ArkX-Lab/Sitara-Project/HW/Document/N1_Block Diagram/Sitara Project_Block Diagram.pptx

Power Input 1
(DC Barrel Jack)

Power Input 2
(USB Type-C)

PMIC Power-On
(Push-Button 1)

PMIC
(TPS65217DRSLR)

3.3V LDO1
(MIC5209YM-TR)

Sitara Processor
(AM3358BZCZ100)

Mezzanine Connector B
(10144517-101802LF)

Main Oscillator
(24MHz)

VTT Regulator
(BD3539FVM-TR)

EEPROM
(AT24C16)

Sub Oscillator
(32.768kHz)

USB1
(USB2.0 Mini-B)

DDR3L Memory
(MT41K256M)

Micro-SD Card Connector (TF-01A)

USB – UART
(CP2102)

RJ45
(HR911105A)

Test LEDs

Test Push-Buttons

eMMC
(MTFC32GAZAQHD-WT)

Mezzanine Connector A
(10144517-101802LF)

## Slide 2

Power Input 1
(DC Barrel Jack)

EXT_VIN_DC

PMIC
(TPS65217DRSLR)

PGOOD_LDO1/2

VOUT_SYS

3.3V LDO1
(MIC5209YM-TR)

MCU
(STM32C011F6U6TR)

VDD/VDDA

Power Input 2
(USB-C Conn.)

EXT_VIN_USB

3.3V LDO2
(AM1117-3.3)

SCL

PB6

PMIC Power-On
(Push-Button 1)

PB_IN

SDA

PB7

PMIC Reset
(Push-Button 2)

nRESET

PGOOD

PA2

PA1

PMIC Power En.
(Slide Switch 1)

PWR_EN

nWAKEUP

nINT

PA4

PA3

PMIC Output Rails
(Connector)

1. DC Barrel Jack
2. PMIC(TPS65217)
3. Power Button
4. LDO(MIC5209)
5. Sitara Processor
6. Oscillator (24MHz/32.768kHz)
7. USB2.0 Mini-B Connector
8. DDR3L Memory

PMIC Status Signals
(Connector)

1. VTT Regulator(BD3539FVM-TR)
2. EEPROM(AT24C16)
3. Micro SD Card Connector(TF-01A)
4. Ethernet PHY(LAN8710)
5. RJ45 Connector(HR911105A)
6. USB-UART Bridge(CP2102)
7. USB2.0 C-Type Connector
8. eMMC(MTFC32GAZA)

PA0

1. Mezzanine Connector (10144517-101802LF)
2. Mount Holes
3. Test LEDs
4. Test Push-Buttons

## Slide 3

Power Input 1
(DC Barrel Jack)

EXT_VIN_DC

PMIC
(TPS65217DRSLR)

PGOOD_LDO1/2

VOUT_SYS

3.3V LDO1
(MIC5209YM-TR)

MCU
(STM32C011F6U6TR)

VDD/VDDA

Power Input 2
(USB-C Conn.)

EXT_VIN_USB

3.3V LDO2
(AM1117-3.3)

SCL

PB6

PMIC Power-On
(Push-Button 1)

PB_IN

SDA

PB7

PMIC Reset
(Push-Button 2)

nRESET

PGOOD

PA2

PA1

PMIC Power En.
(Slide Switch 1)

PWR_EN

nWAKEUP

nINT

PA4

PA3

PMIC Output Rails
(Connector)

1. DP5VS
2. DP1.35V (DCDC1’s Vout)
3. DP1.1V (DCDC2’s Vout)
4. DP1.1V (DCDC3’s Vout)
5. DP1.8V (LDO1’s Vout)
6. DP3.3V (LDO2’s Vout)
7. DP1.8V (LDO3’s Vout)
8. DP3.3V (LDO4’s Vout)

PMIC Status Signals
(Connector)

1. MCU PMIC Power Enable
2. MCU PMIC PGOOD
3. MCU PMIC LDO PGOOD
4. MCU PMIC nINT
5. MCU PMIC nWAKEUP
6. MCU I2C1 SCL
7. MCU I2C1 SDA

PA0

## Slide 4

Power Input 1
(DC Barrel Jack)

EXT_VIN_DC

PMIC
(TPS65217DRSLR)

PGOOD_LDO1/2

VOUT_SYS

3.3V LDO1
(MIC5209YM-TR)

MCU
(STM32C011F6U6TR)

VDD/VDDA

Power Input 2
(USB-C Conn.)

EXT_VIN_USB

3.3V LDO2
(AM1117-3.3)

SCL

PB6

PMIC Power-On
(Push-Button 1)

PB_IN

SDA

PB7

PMIC Reset
(Push-Button 2)

nRESET

PGOOD

PA2

PA1

PMIC Power En.
(Slide Switch 1)

PWR_EN

nWAKEUP

nINT

PA4

PA3

PMIC Output Rails
(Connector)

1. DP5VS
2. DP1.35V (DCDC1’s Vout)
3. DP1.1V (DCDC2’s Vout)
4. DP1.1V (DCDC3’s Vout)
5. DP1.8V (LDO1’s Vout)
6. DP3.3V (LDO2’s Vout)
7. DP1.8V (LDO3’s Vout)
8. DP3.3V (LDO4’s Vout)

PMIC Status Signals
(Connector)

1. MCU PMIC Power Enable
2. MCU PMIC PGOOD
3. MCU PMIC LDO PGOOD
4. MCU PMIC nINT
5. MCU PMIC nWAKEUP
6. MCU I2C1 SCL
7. MCU I2C1 SDA

PA0

## Slide 5

XC7Z010 Test B’d (Rev.A)

External Connector
(Edge Connector : DDR4 SODIMM Form Factor)

JTAG
Digilent JTAG-HS3 Compatible

AMD Xilinx
Zynq
System-On-Chip
(XC7Z010-1CLG400)

QSPI FLASH
(16MB)

PS Clock OSC
(33.33MHz)

PL Clock OSC
(50MHz)

VTT Regulator
(0.675V)

DDR3L Memory
(512MB)

DDR3L Memory
(512MB)

Termination

Rev. A

## Slide 6

# 1Q TSN MPW - Block Diagram

Clock domain :
2.5 or 25MHZ
(from PHY IC)

Clock domain :
100MHz
(from Oscillator)

1Q TSN MPW

Raspberry
PI4

SPI
Periph
(Master)

GPIOs
(Interrupt
Avaliable)

10/100
MAC IP

Rx MAC FIFO
(4KB)

TSN Rx module

1Q
TSN
I/F

Frame Rx
FIFO

Frame Tx
FIFO

SPI
Slave
I/F

SPI
Slave
IP

Side-band Signals
(Rx INT, Status, Etc)

SCLK

MOSI

Tx MAC FIFO
(4KB)

TSN Tx module

Reg. Write
FIFO

Reg. Read
FIFO

MISO

System Reg
module

NSS

TSN Control
module

## Slide 7

재설계 1Q TSN(V3) Block Diagram (Datapath)

Host Processor

PCIe Gen.2

Clock domain :
from Oscillator

Clock domain :
from XDMA

Tri-Mode Ethernet MAC

osc_diff_clk

8-bit AXIS

TSN Rx module

8-bit AXIS

AXI4-Stream Data Width Converter
(8bit to 128bit)

128-bit AXIS

AXI-Stream Data FIFO
(128bit)

CDC module

CDC FIFO 1
(TSN Control & Config)

CDC FIFO 2
(System Counter)

CDC FIFO 3~6
(Tx Timestamp 1~4)

CDC FIFO 7
(Tx Status)

CDC FIFO 8
(Rx Status)

CDC FIFO 9
(Other Status)

AXI-Stream Data FIFO
(128bit)

128-bit AXIS

XDMA
(PCIe Gen.2)

CDC FIFO

AXI4L Reg
module

128-bit AXIS

CDC FIFO

System Reg
module

Dedicated Wire

Dedicated Wire

32-bit AXIL

8-bit AXIS

TSN Tx module

CDC FIFO

TSN Clock

System Counter

Timestamp Generator

Dedicated Wire

Reset & Clock
Controller
