ArkX-Lab/Sitara-Project/HW/Document/BOM/01_Required Part List/Main Part List of BeagleBoneBlack.xlsx

Main Part List of BeagleBoneBlack
No. | Category |  | Part Name | Description | Manufacturer | Req. Qty | Supplier 1 : JLCPCB (LCSC) |  |  | Supplier 2 : Digikey |  |  | Purchase Price | Datasheet | Note
 | Main | Sub Category |  |  |  |  | Stock | Unit Price | Total Price | Stock | Unit Price | Total Price
1 | IC | PMIC | TPS65217CRSLR | Single-Chip PMIC for Battery-Powered Systems | Texas Instruments | 1 | 305 | $2.231 | $2.23 | 2259 | $5.200 | $5.20 | $2.23 | Datasheet (https://www.ti.com/lit/ds/symlink/tps65217.pdf?HQS=dis-dk-null-digikeymode-dsf-pf-null-wwe&ts=1737040409403)
2 | IC | LDO | TL5209DR | 500-mA Low-Noise Low-Dropout Voltage Regulator With Shutdown | Texas Instruments | 1 | 65 | $1.125 | $1.12 | 0 | $1.520 | $1.52 | $1.12 | Datasheet (https://www.ti.com/general/docs/suppproductinfo.tsp?distId=10)
3 | IC | Buffer | SN74LVC1G07DCKR | Single Buffer/Driver With Open-Drain Output | Texas Instruments | 1 | 11337 | $0.048 | $0.05 | 110269 | $0.100 | $0.10 | $0.05 | Datasheet (https://www.ti.com/lit/ds/symlink/sn74lvc1g07.pdf?ts=1695839538574)
4 | IC | D-FlipFlop | SN74LVC1G74DCTR | Single Positive-Edge-Triggered D-Type Flip-Flop with Clear and Preset | Texas Instruments | 1 | 186 | $0.354 | $0.35 | 23303 | $0.500 | $0.50 | $0.35 | Datasheet (https://www.ti.com/general/docs/suppproductinfo.tsp?distId=10)
5 | IC | Inverter | SN74LVC1G06DCKR | Single Inverter Buffer/Driver With Open-Drain Output | Texas Instruments | 1 | 1456 | $0.065 | $0.07 | 41948 | $0.100 | $0.10 | $0.07 | Datasheet (https://www.ti.com/lit/ds/symlink/sn74lvc1g06.pdf?HQS=dis-dk-null-digikeymode-dsf-pf-null-wwe&ts=1737041288845)
6 | Osc | Osc | 24.576MHz Oscillator | 24.576MHz Oscillator | - | 1 | - | - | - | - | - | - |  |  | 제품 선정 필요
7 | IC | MPU | AM3358BZCZ100 | Up to 1GHz Sitrara ARM Cortex-A8 32-bit RISC Processor | Texas Instruments | 1 | 219 | $12.219 | $12.22 | 149 | $18.790 | $18.79 | $12.22 | Datasheet (https://www.ti.com/lit/ds/symlink/am3352.pdf?HQS=dis-dk-null-digikeymode-dsf-pf-null-wwe&ts=1737014458424)
8 | IC | Buffer | SN74LVC2G241DCUR | Dual Buffer and Driver With 3-State Outputs | Texas Instruments | 1 | 3266 | $0.341 | $0.34 | 14155 | $0.450 | $0.45 | $0.34 | Datasheet (https://www.ti.com/lit/ds/symlink/sn74lvc2g241.pdf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)
9 | IC | Load Switch | TPS2051BDGNR | Current-Limited, Power-Distribution Switches | Texas Instruments | 1 | 0 | $0.960 | $0.96 | 6079 | $0.960 | $0.96 | $0.96 | Datasheet (https://www.ti.com/general/docs/suppproductinfo.tsp?distId=10)
10 | Passive | TVS Diode | TPD4S012DRYR | 4-Channel ESD Solution for USB-HS/USB OTG/USB Charger Interface | Texas Instruments | 2 | 224 | $0.170 | $0.34 | 27863 | $0.690 | $1.38 | $0.34 | Datasheet (https://www.lcsc.com/datasheet/lcsc_datasheet_1809050016_Texas-Instruments-TPD4S012DRYR_C96506.pdf)
11 | IC | DDR3L | D2516ECMDXGJD-U | 4G bits DDR3L SDRAM | Kingston | 1 | - | - | - | 259 | $3.980 | $3.98 |  | Datasheet (https://mm.digikey.com/Volume0/opasdata/d220001/medias/docus/6165/D2516ECMDXG.pdf) | "MT41K256M16TW-107 IT:P"으로 대체 예정
12 | IC | DDR3L | MT41K256M16TW-107 IT:P | 1.35V DDR3L SDRAM | Micron | 1 | 2576 | $1.476 | $1.48 | 1211 | $6.400 | $6.40 | $1.48 | Datasheet (https://wmsc.lcsc.com/wmsc/upload/file/pdf/v2/lcsc/2304140030_Micron-Tech-MT41K256M16TW-107-IT-P_C367428.pdf) | "D2516ECMDXGJD-U"의 대체품
13 | IC | eMMC | MTFC4GLDEA-0M WT TR | MultiMediaCard (MMC) controller and NAND Flash. 153- or 169-ball WFBGA/VFBGA/LFBGA (RoHS 6/6-compliant) | Micron | 1 | EOL | - | - | EOL | - | - |  | Datasheet (https://mm.digikey.com/Volume0/opasdata/d220001/medias/docus/1197/EMMC_Series.pdf) | 단종 => 대체품 검토 필요
14 | IC | eMMC | MTFC32GAZAQHD-WT | FLASH - NAND Memory IC 256Gbit MMC 200 MHz 153-VFBGA (11.5x13) | Micron | 1 | 0 | $20.175 | $20.18 | 794 | $18.710 | $18.71 | $18.71 | Local | "MTFC4GLDEA-0M WT TR"의 대체품
15 | IC | Ethernet Trcv | LAN8710A-EZC-TR | Small Footprint MII/RMII 10/100 Ethernet Transceiver with HP Auto-MDIX and flexPWR® Technology | Microchip | 1 | 17582 | $0.645 | $0.65 | 5178 | $1.580 | $1.58 | $0.65 | Datasheet (https://ww1.microchip.com/downloads/en/DeviceDoc/00002164B.pdf)
16 | IC | AND-Gate | SN74AHC1G09DCKR | Single 2–Input Positive-AND Gate With Open-Drain Output | Texas Instruments | 1 | 1 | $0.054 | $0.05 | 4613 | $0.120 | $0.12 | $0.12 | Datasheet (https://www.ti.com/lit/ds/symlink/sn74ahc1g09.pdf?HQS=dis-dk-null-digikeymode-dsf-pf-null-wwe&ts=1737065378387)
17 | IC | HDMI | TDA19988BHN/C1,557 | Video Transmitter IC I2S HDMI 1.4a, ITU656 64-HVQFN (9x9) Package | NXP | 1 | EOL | - | - | EOL | - | - |  | Datasheet (https://mm.digikey.com/Volume0/opasdata/d220001/medias/docus/957/TDA19988_DS_21_july_2011.pdf) | 단종 => 대체품 검토 필요
 |  |  |  |  |  |  |  |  |  | Total Price (Dollar / Won) |  |  | $38.63
 |  |  |  |  |  |  |  |  |  |  |  |  | $56343.57739
