ArkX-Lab/Sitara-Project/HW/Document/Design/Design Check List/B'd Design Check List.xlsx

Schematic Design Check List
No. | Main Category | Sub Category | Description | Note | Source
1 | DDR Memory | Pin Attribute | "DDR_VREF" Pin => 이 핀은 DDR 입력 버퍼의 스위칭 스레스홀드를 (VDDS_DDR/2)로 설정하는데 사용되는 아날로그 전압이라고 한다. | 이 내용에서 알 수 있는 사실은 DDR 메모리의 타켓 임피던스가 50옴이라는 것이다. 그리고 설계자가 이를 위해, 49.9옴 저항을 연결해주어야 한다는 것이다. | AM335x Sitara Processor Datasheet 21p
2 | DDR Memory | Pin Attribute | "DDR_VTP" Pin => 이 핀은 외부 49.9Ohm 1% 저항과 연결한다고 한다. DDR Input/Output Buffer를 Calibration 하기 위함. | 이 내용에서 알 수 있는 사실은 DDR 메모리의 타켓 임피던스가 50옴이라는 것이다. 그리고 설계자가 이를 위해, 49.9옴 저항을 연결해주어야 한다는 것이다. | AM335x Sitara Processor Datasheet 21p
 | BOOT |  | "LCD_DATA[15:0]" => 이 16개 핀들은 SYSBOOT[15:0] 핀이기도 하다. "PWRONRSTn" 신호의 라이징 엣지에서 래치된다. |  | AM335x Sitara Processor Datasheet 21p
 | Supply Voltage |  | Datasheet "Table 5-3"에 동작 스피드별로 VDD_MPU 전압이 다르다. BBB에서는 1.1V로 공급하는데, AM3358BZCZ100은 1GHz 사양으로서 1.26V가 공급되어야 올바른 것이 아닌가? 그냥 OPP100을 기준으로 생각하면 되나? => PMIC의 DCDC2 전압 설정값을 확인해볼 필요가 있다. Table 5-3 (2)에 OPP100은 500MHz 또는 그 이상의 디바이스에 대해서 적용된다고 한다. 따라서, 1GHz 속도의 AM3358~ZCZ100은 OPP100을 기준으로 하면 되는건가? OPP는 공급 전압에 따라서, 내부적으로 결정되는건가? OPP 설정에 따라 동작 속도를 가변하나? | Table 5-3에는 이전 실리콘 버전의 ARM 동작속도로 기재되어 있다. => Table 3-1의 (1) 참조
 | Decoupling Cap | Core | Core Voltage Decoupling Capacitors의 값 => "Table 5-13"에 따르면, VDD_CORE, VDD_MPU는 각각 최소 10uF 1개와 10nF 8개를 권고한다.
 | Decoupling Cap | I/O & Analog | I/O 및 Analog 핀에 대한 Cap 값들은 "Table 5-14"를 참고한다.
 | Decoupling Cap | Output Capacitor | "Table 5-15" 참조
 | Supply Voltage | USB | USB를 사용하지 않는 경우, 해당 전원 핀의 처리는 "Figure 6-2"의 C를 따른다.
 | Power Monitor |  | VDD_MPU_MON : 사용하지 않는 경우, "Figure 6-7"에 따라 처리할 것
 | Clock | Crystal | OSC0는 RTC를 제외한 모든 영역에서 사용되는 클락의 소스이고, OSC1은 RTC의 클락 소스이다. 외부 크리스탈 주파수 사양과 커패시터 사용은 "Table 6-2"를 참조한다.
 | Reset |  | Power On Reset에 대한 내용은 TRM의 1238p를 참조한다.
 |  |  | NRESET_INOUT 관련 버퍼 회로의 설계 내용은 TRM의 Figure 8-24를 참조한다.
