ArkX-Lab/Sitara-Project/HW/Rev_A/Sitara_Project_Rev_A/Sitara_Project_Rev_A/Sitara_Project_Rev_A.pdf

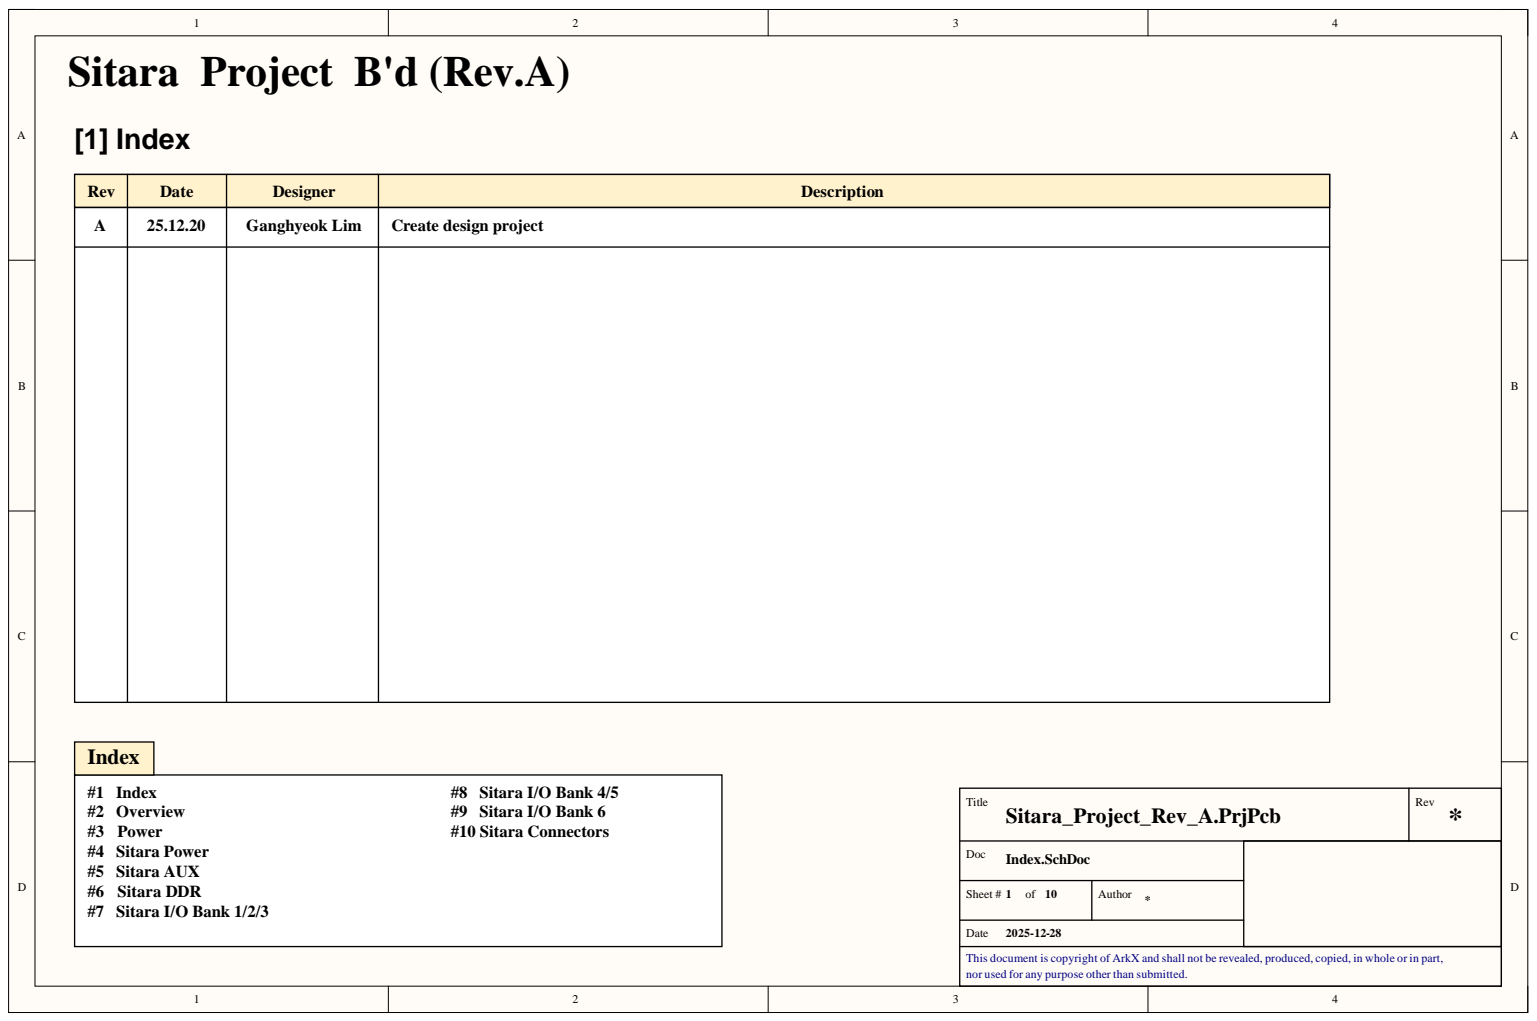
[picture p1: page 1]

Rev | Date | Designer | Description

A | 25.12.20 | Ganghyeok Lim | Create design project

Title Sitara_Project_Rev_A.PrjPcb | Rev *

Doc Index.SchDoc

Sheet # 1 of 10 | Author *

This document is copyright of ArkX and shall not be revealed, produced, copied, in whole or in part,
nor used for any purpose other than submitted.

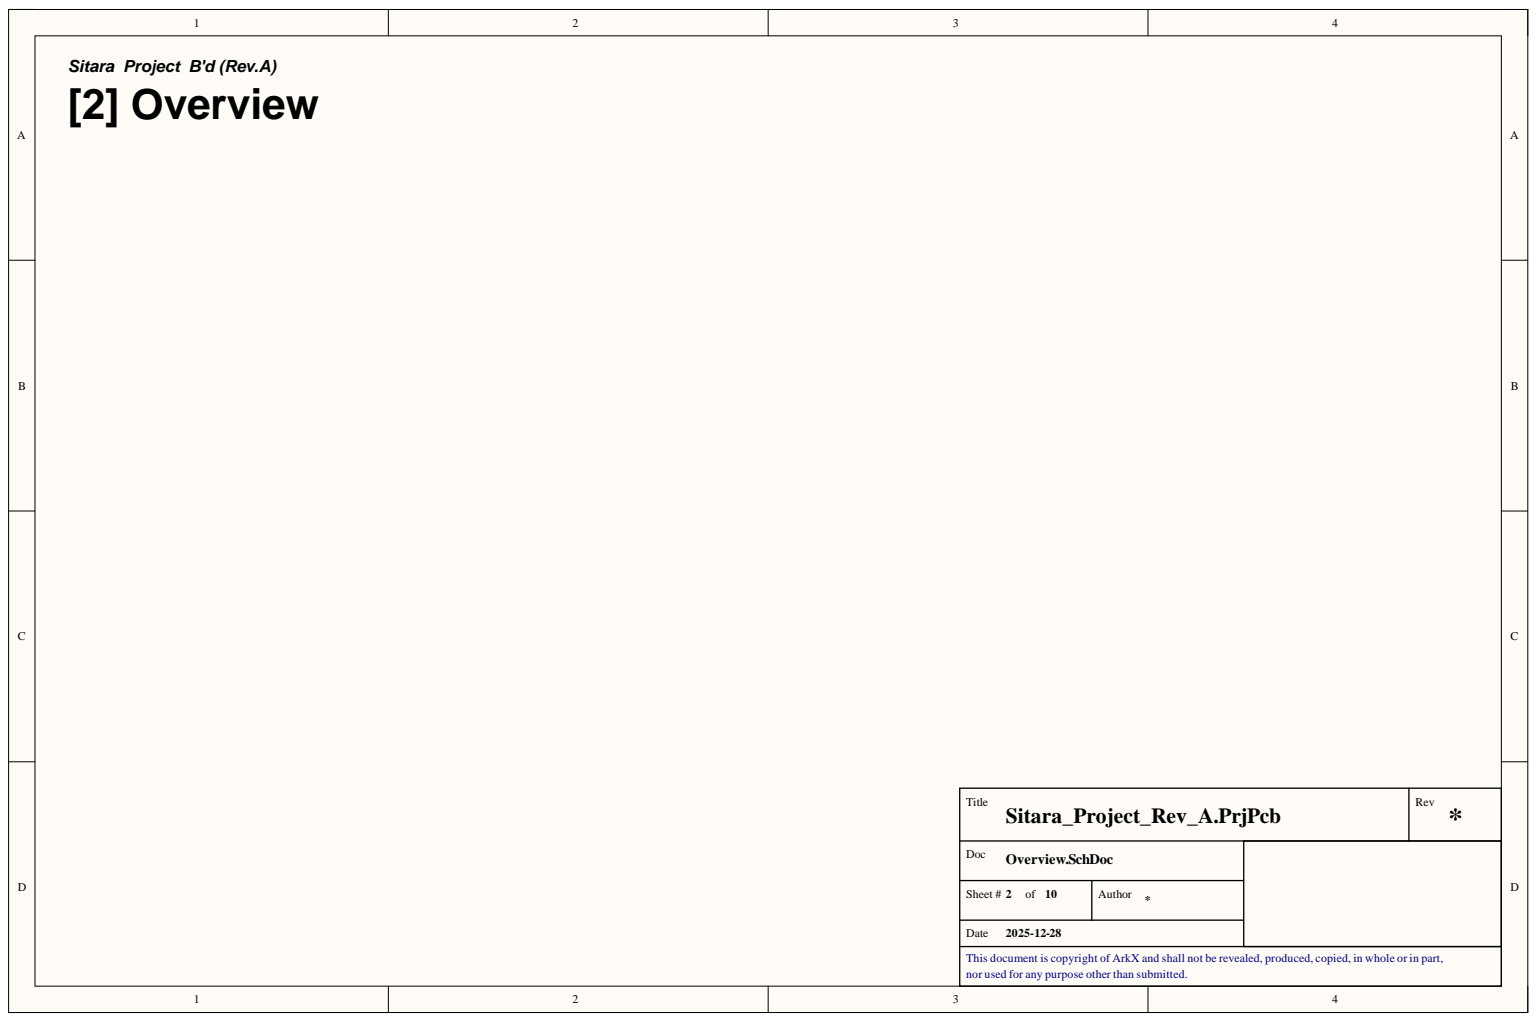
[picture p2: page 2]

Title Sitara_Project_Rev_A.PrjPcb | Rev *

Doc Overview.SchDoc

Sheet # 2 of 10 | Author *

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

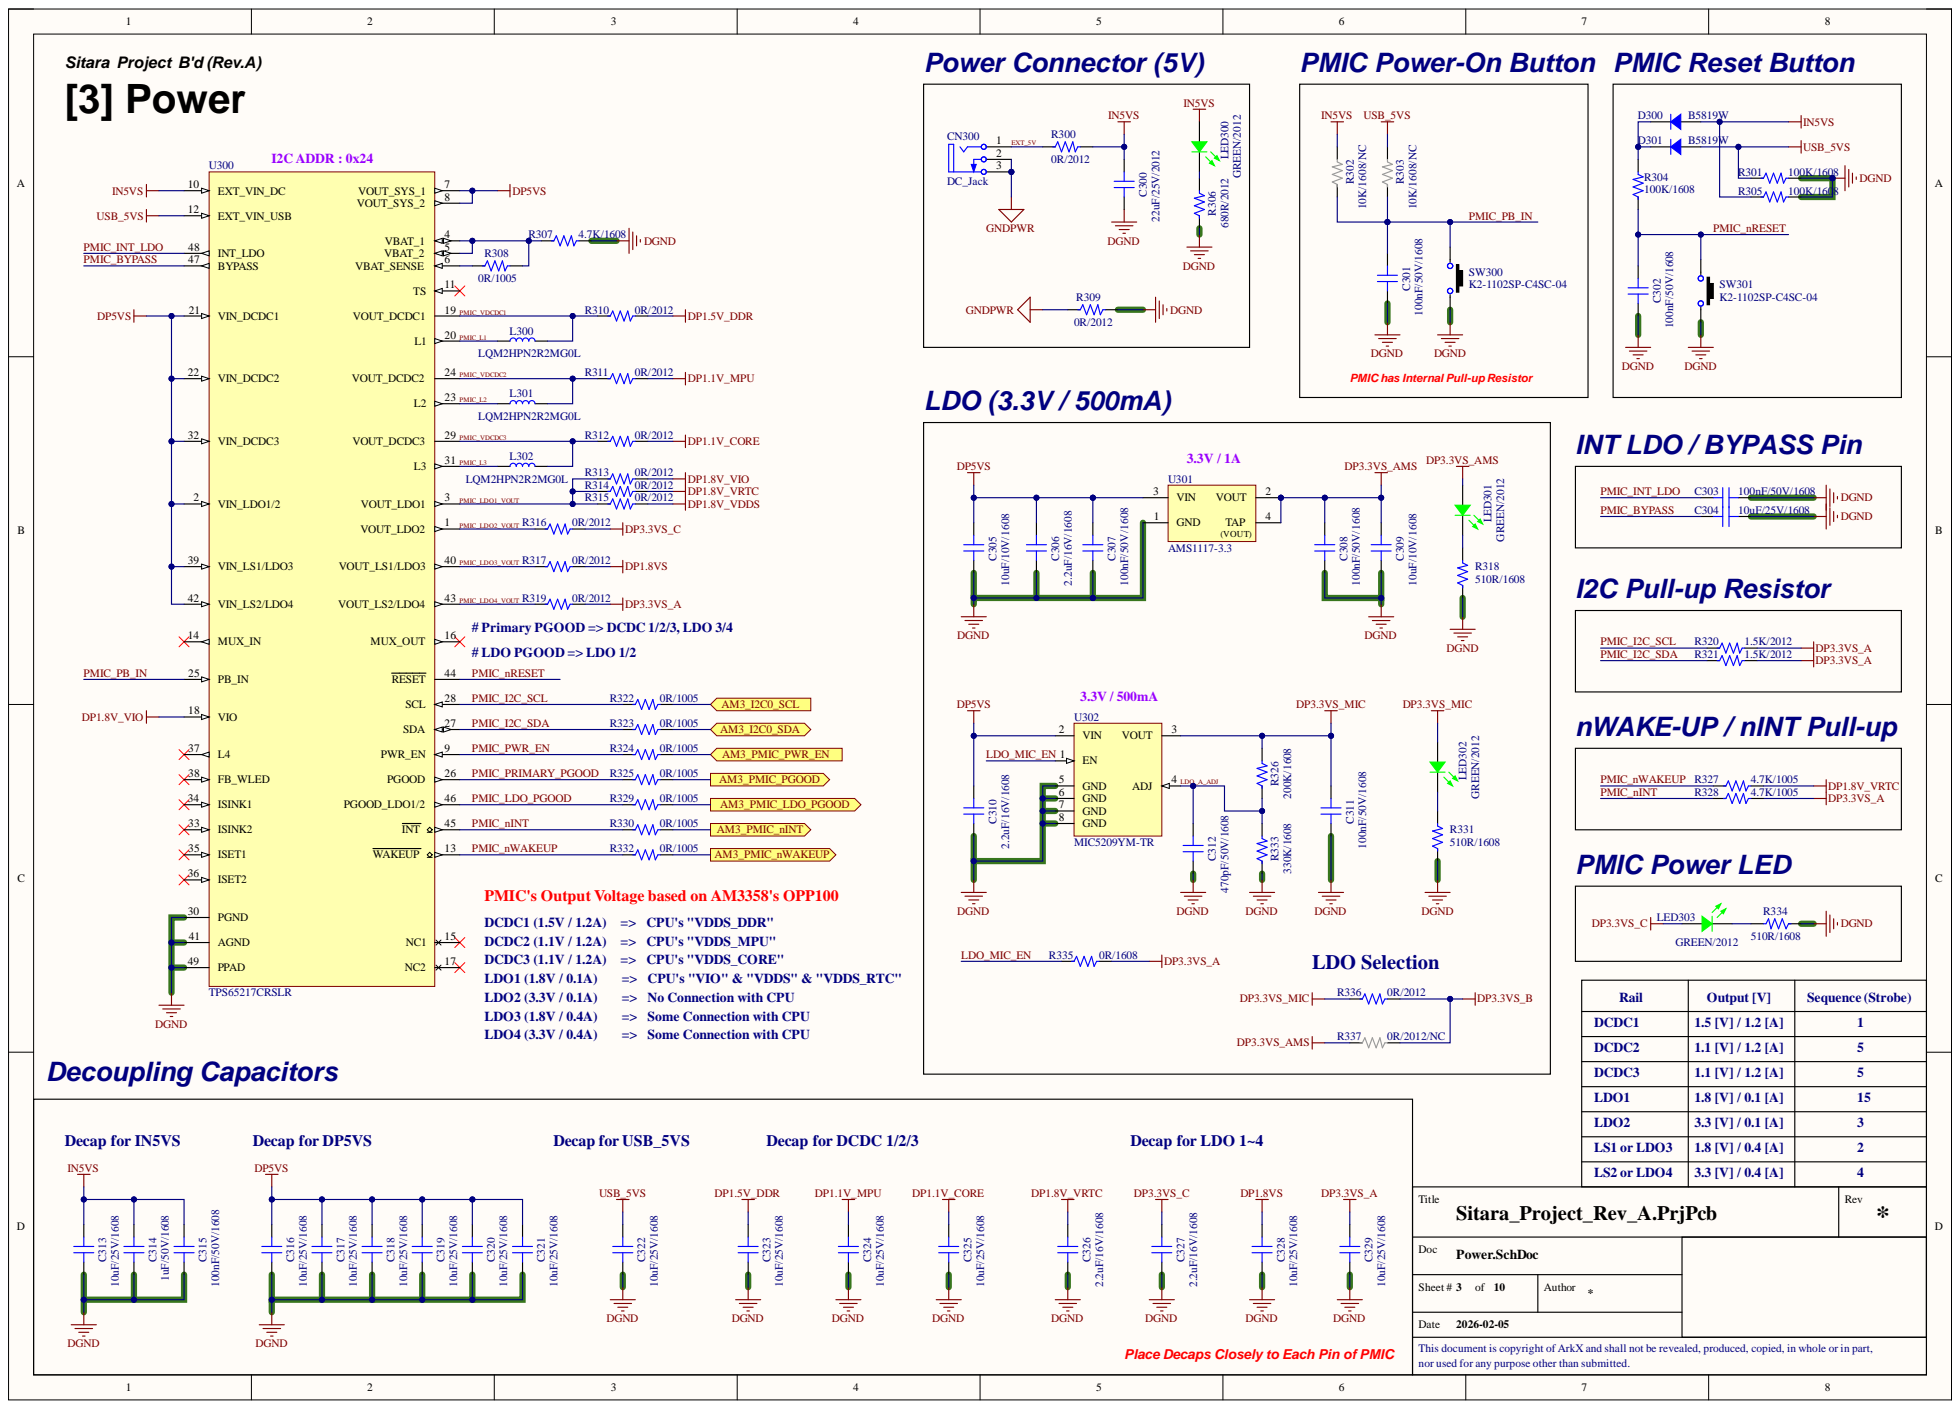
[picture p3: page 3]

PMIC Power-On Button

VIN_DCDC1 21

VIN_DCDC2 22

PMIC has Internal Pull-up Resistor

VIN_DCDC3 32

INT LDO / BYPASS Pin

# Primary PGOOD => DCDC 1/2/3, LDO 3/4

nWAKE-UP / nINT Pull-up

PMIC's Output Voltage based on AM3358's OPP100

AGND 41

GREEN/2012

PPAD 49

Rail | Output [V] | Sequence (Strobe)

DCDC1 | 1.5 [V] / 1.2 [A] | 1

DCDC2 | 1.1 [V] / 1.2 [A] | 5

DCDC3 | 1.1 [V] / 1.2 [A] | 5

LDO1 | 1.8 [V] / 0.1 [A] | 15

LDO2 | 3.3 [V] / 0.1 [A] | 3

LS1 or LDO3 | 1.8 [V] / 0.4 [A] | 2

LS2 or LDO4 | 3.3 [V] / 0.4 [A] | 4

Title Sitara_Project_Rev_A.PrjPcb | Rev *

Doc Power.SchDoc

Sheet # 3 of 10 | Author *

Place Decaps Closely to Each Pin of PMIC

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

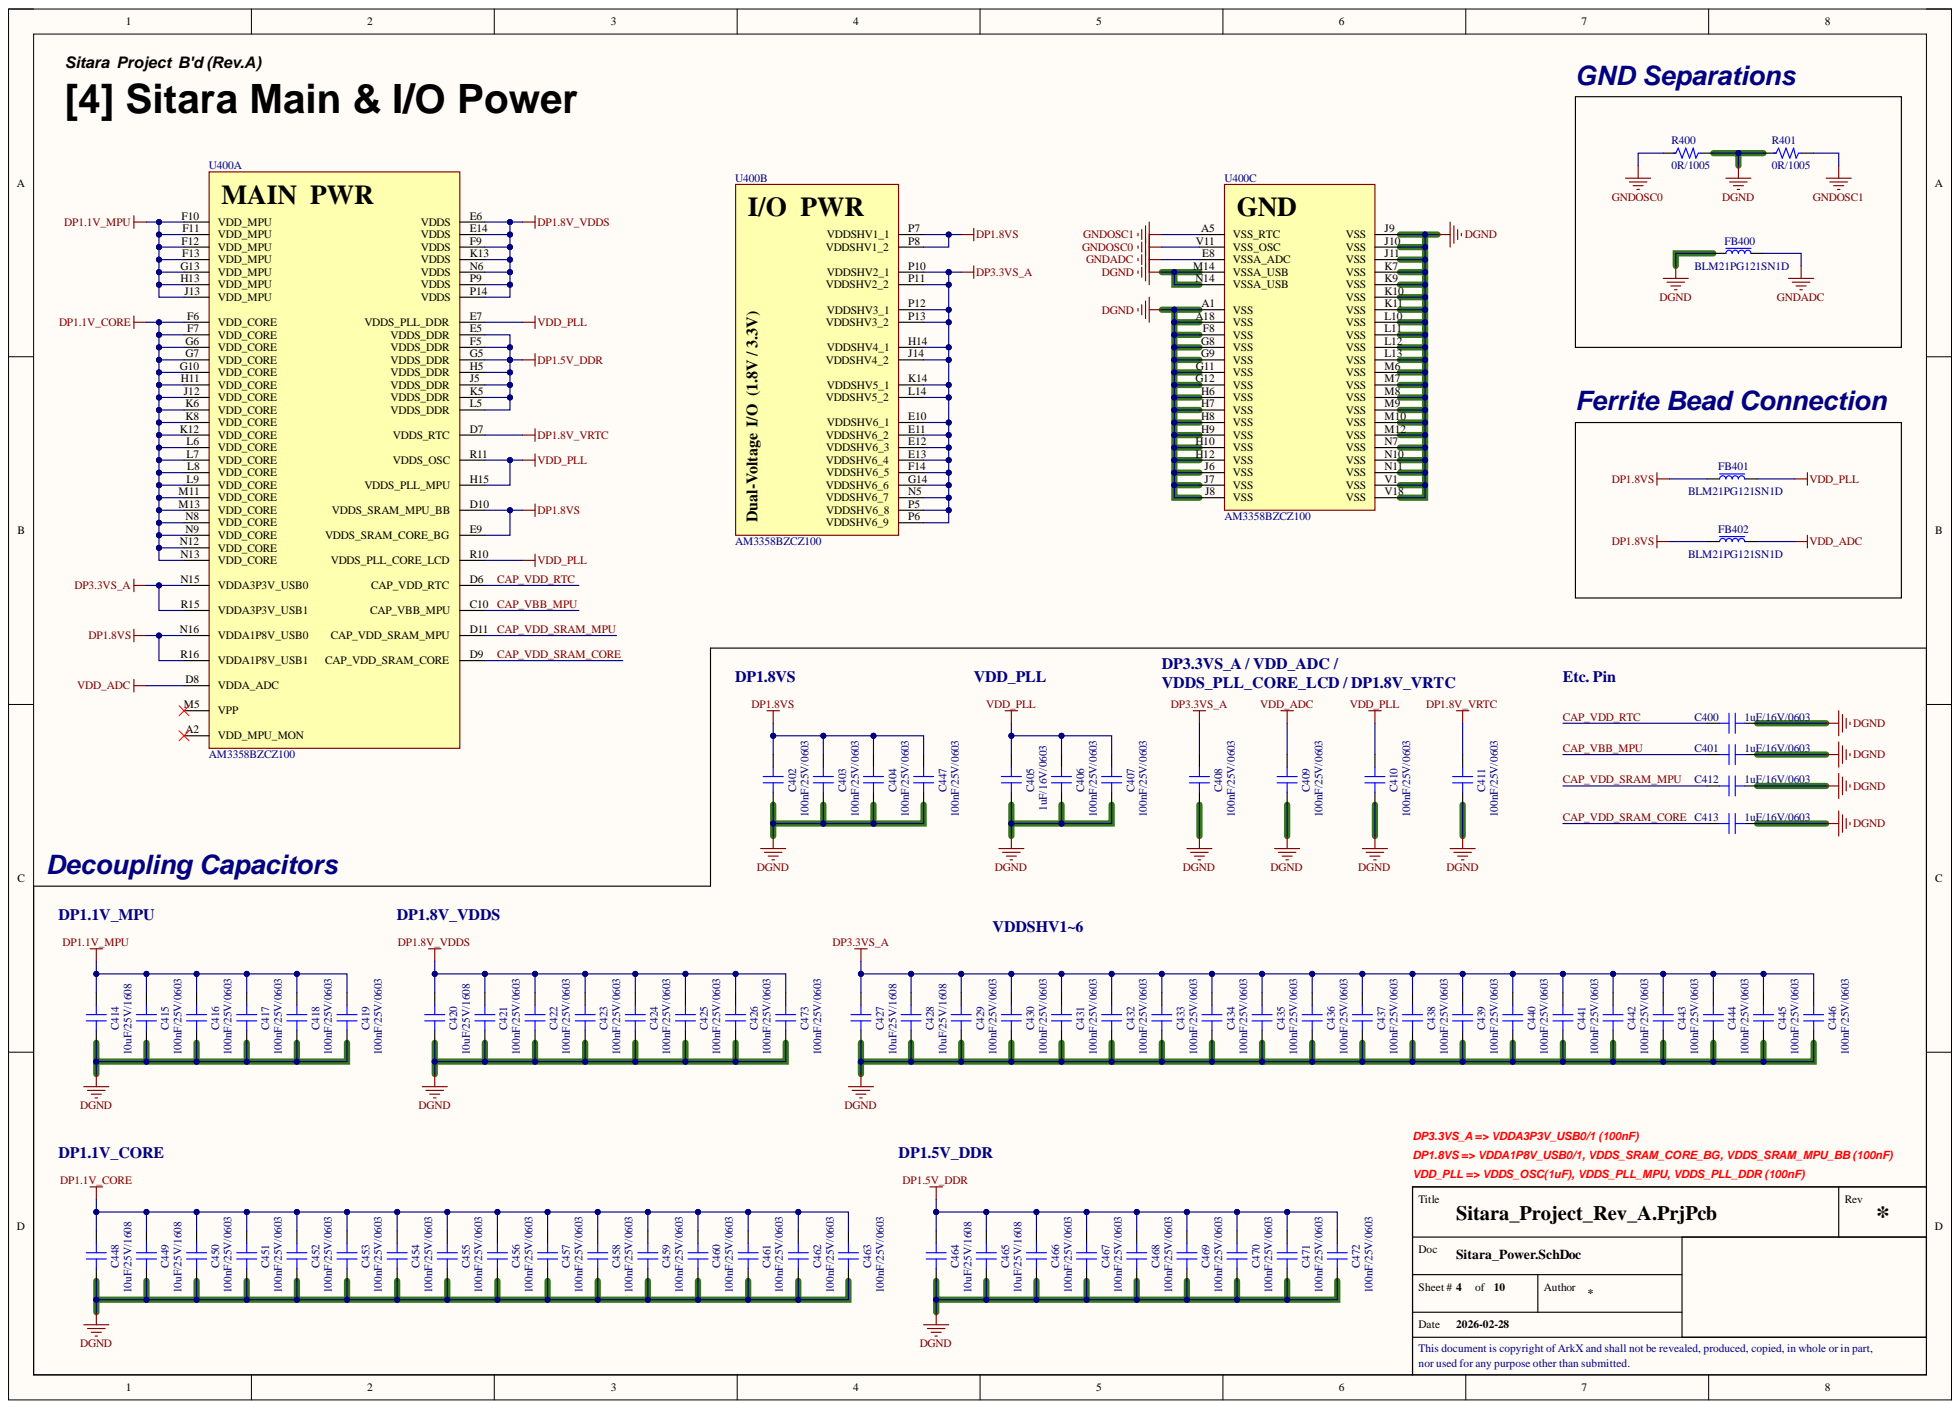
[picture p4: page 4]

VDDA3P3V_USB1 R15

VDDA1P8V_USB0 N16

Title Sitara_Project_Rev_A.PrjPcb | Rev *

Doc Sitara_Power.SchDoc

Sheet # 4 of 10 | Author

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

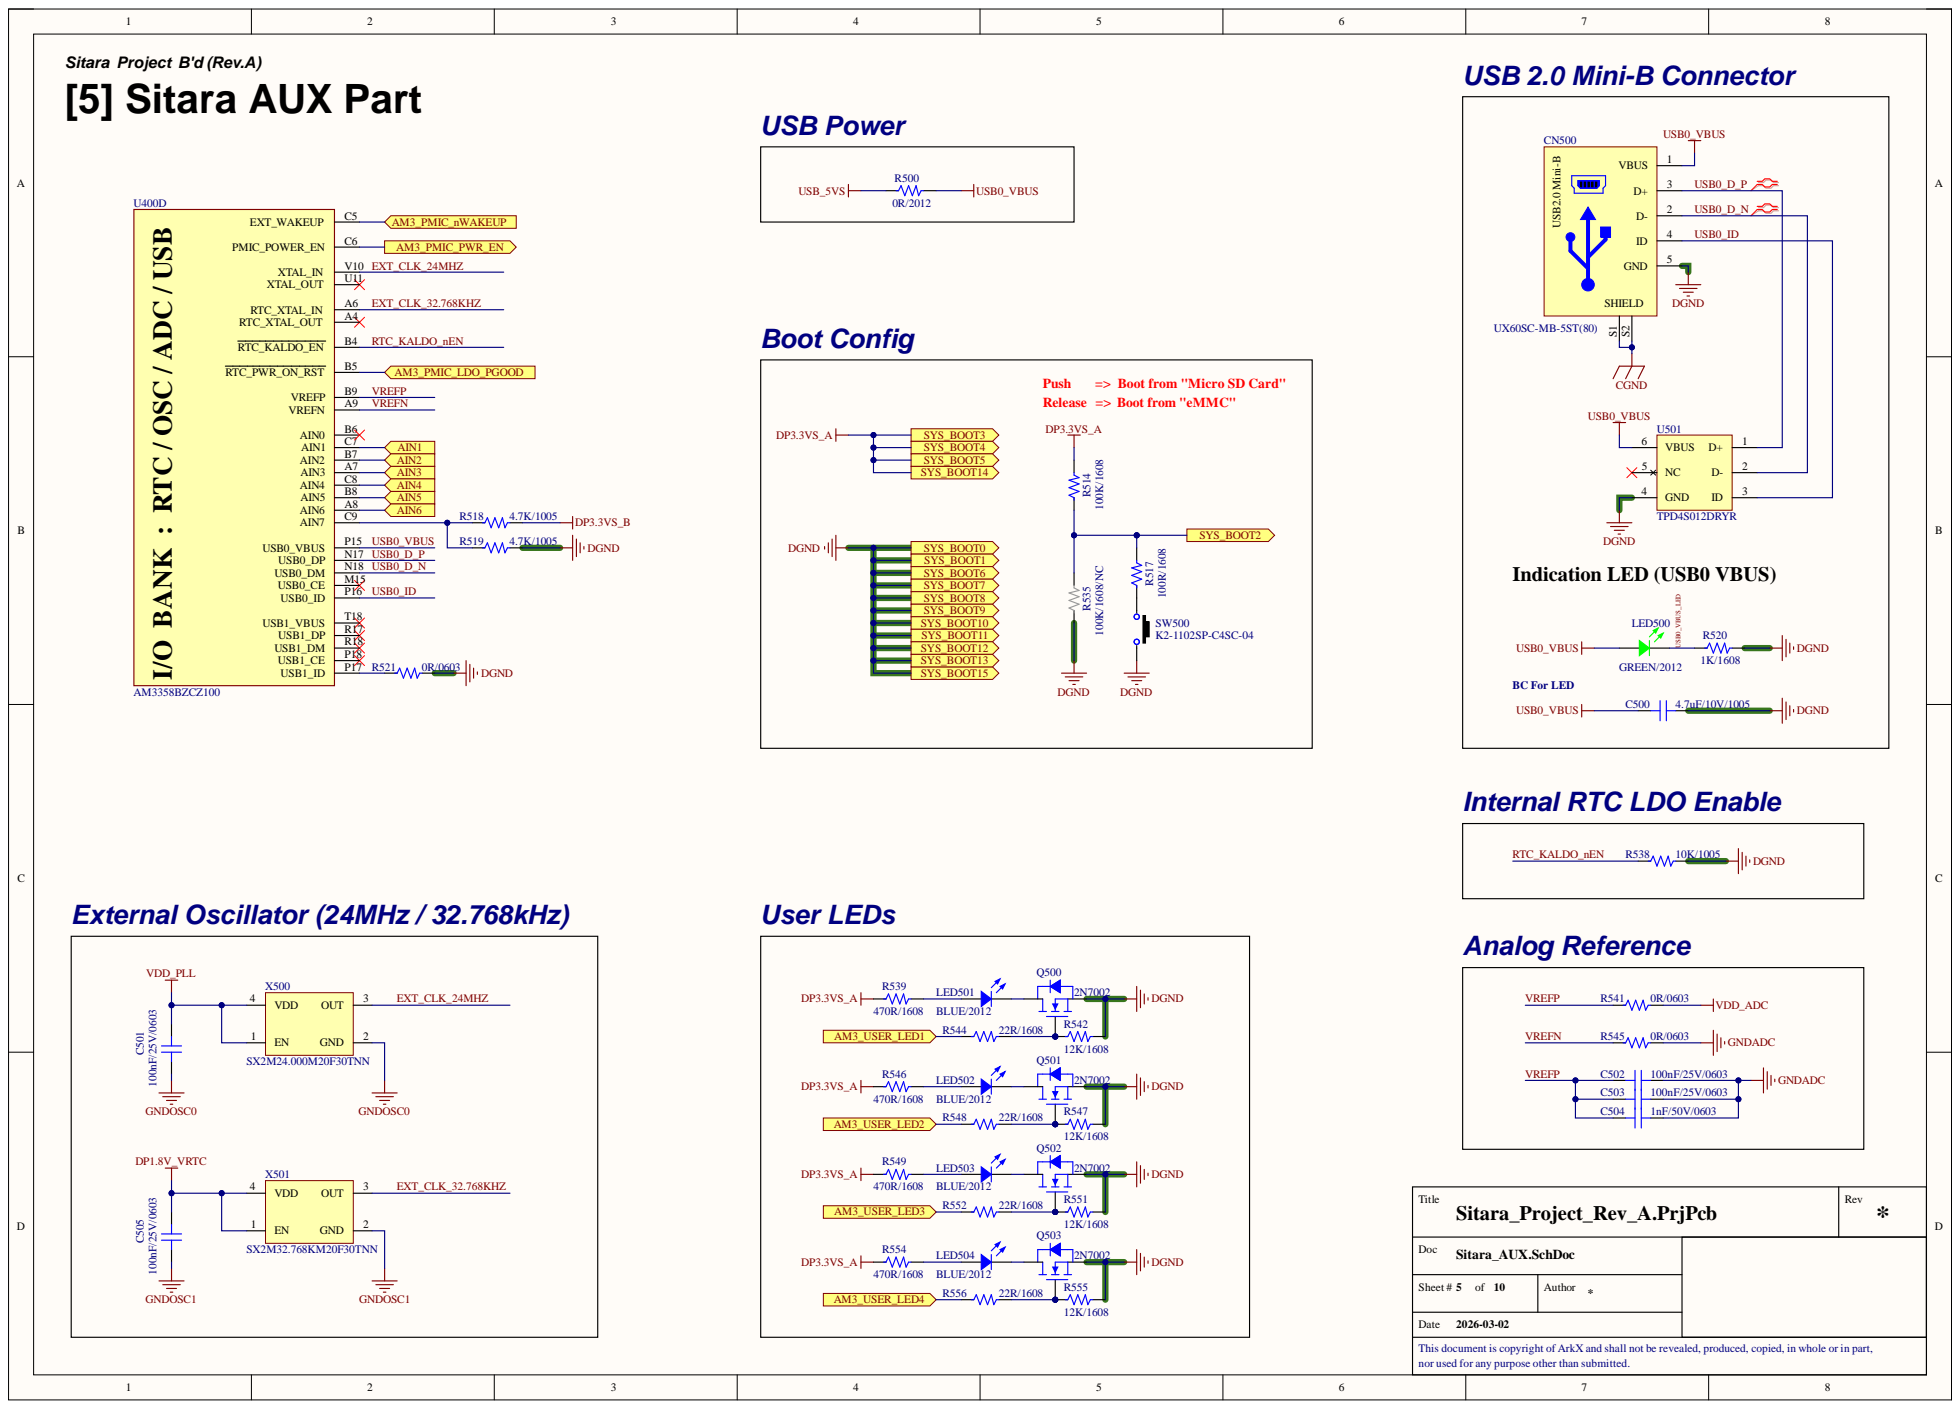
[picture p5: page 5]

I/O BANK : RTC / OSC / ADC / USB

Internal RTC LDO Enable

Analog Reference VREFN VREFP

s document
for any purpose other

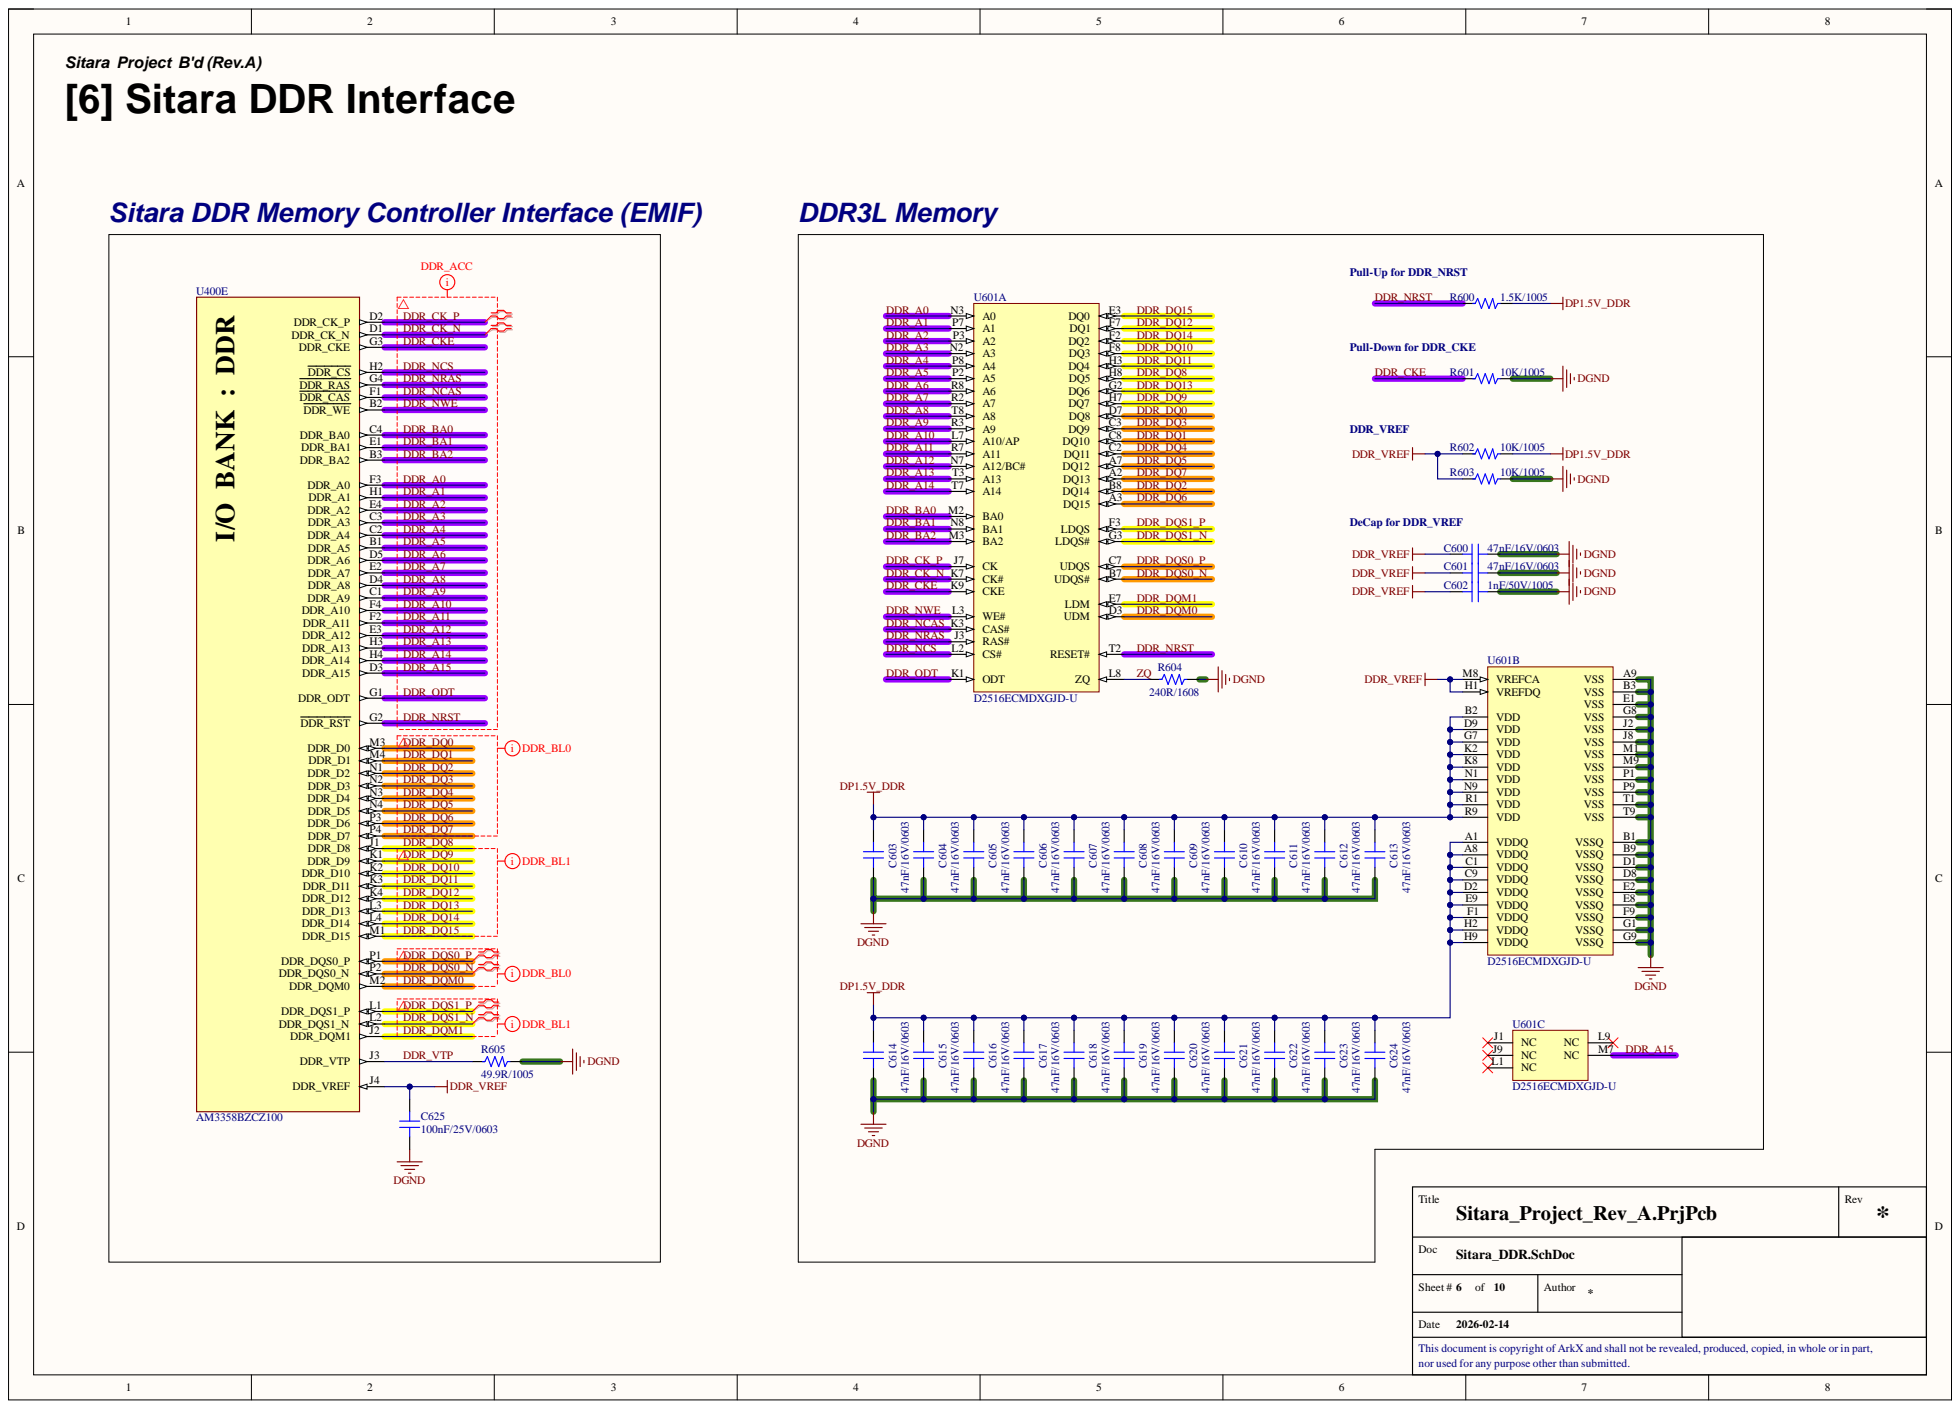
[picture p6: page 6]

Sitara DDR Memory Controller Interface (EMIF) i DDR_ACC

D 9 | J 2
G 7 | J 8
K 2 | M 1
K 8 | M 9

R 1 | T 1
R 9 | T 9

C 1 | D 1
C 9 | D 8
D 2 | E 2
E 9 | E 8

Ti t l e Sitara_Project_Rev_A.Prj P c b | Rev *

Doc S itara_D D R.S c h Doc

Sheet # 6 of 10 | Autho r

s document
for any purpose other

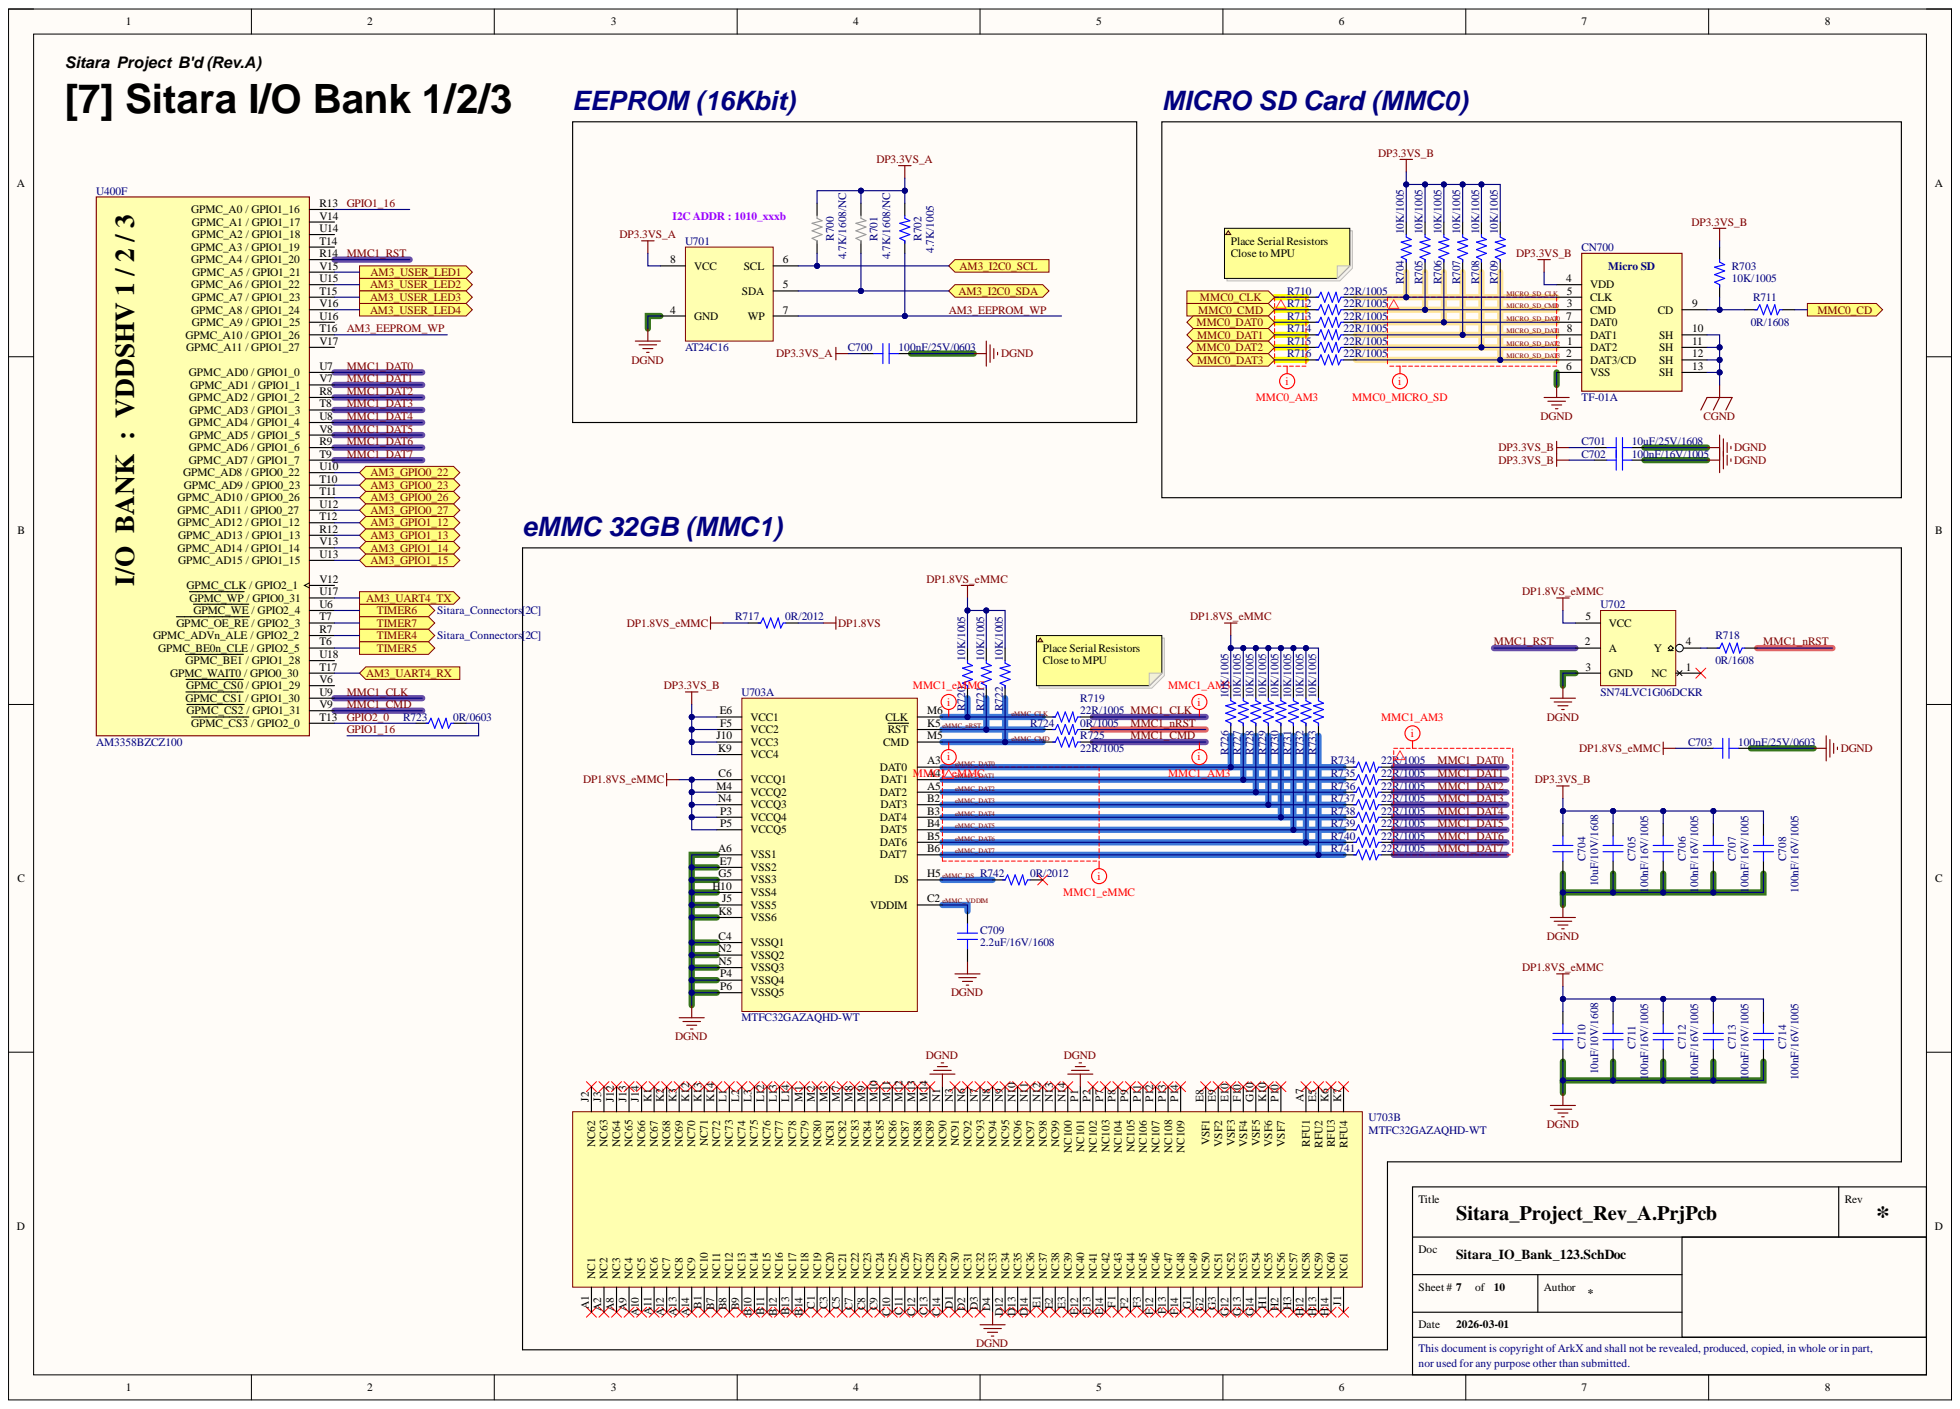
[picture p7: page 7]

R712 | 22R/1005 | MICRO_SD_CMD | CMD 3

R713 | 22R/1005 | MICRO_SD_DAT0 | DAT0 7

R714 | 22R/1005 | MICRO_SD_DAT1 | DAT1 8

Title Sitara_Project_Rev_A.PrjPcb | Rev *

Doc Sitara_IO_Bank_123.SchDoc

Sheet # 7 of 10 | Author

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

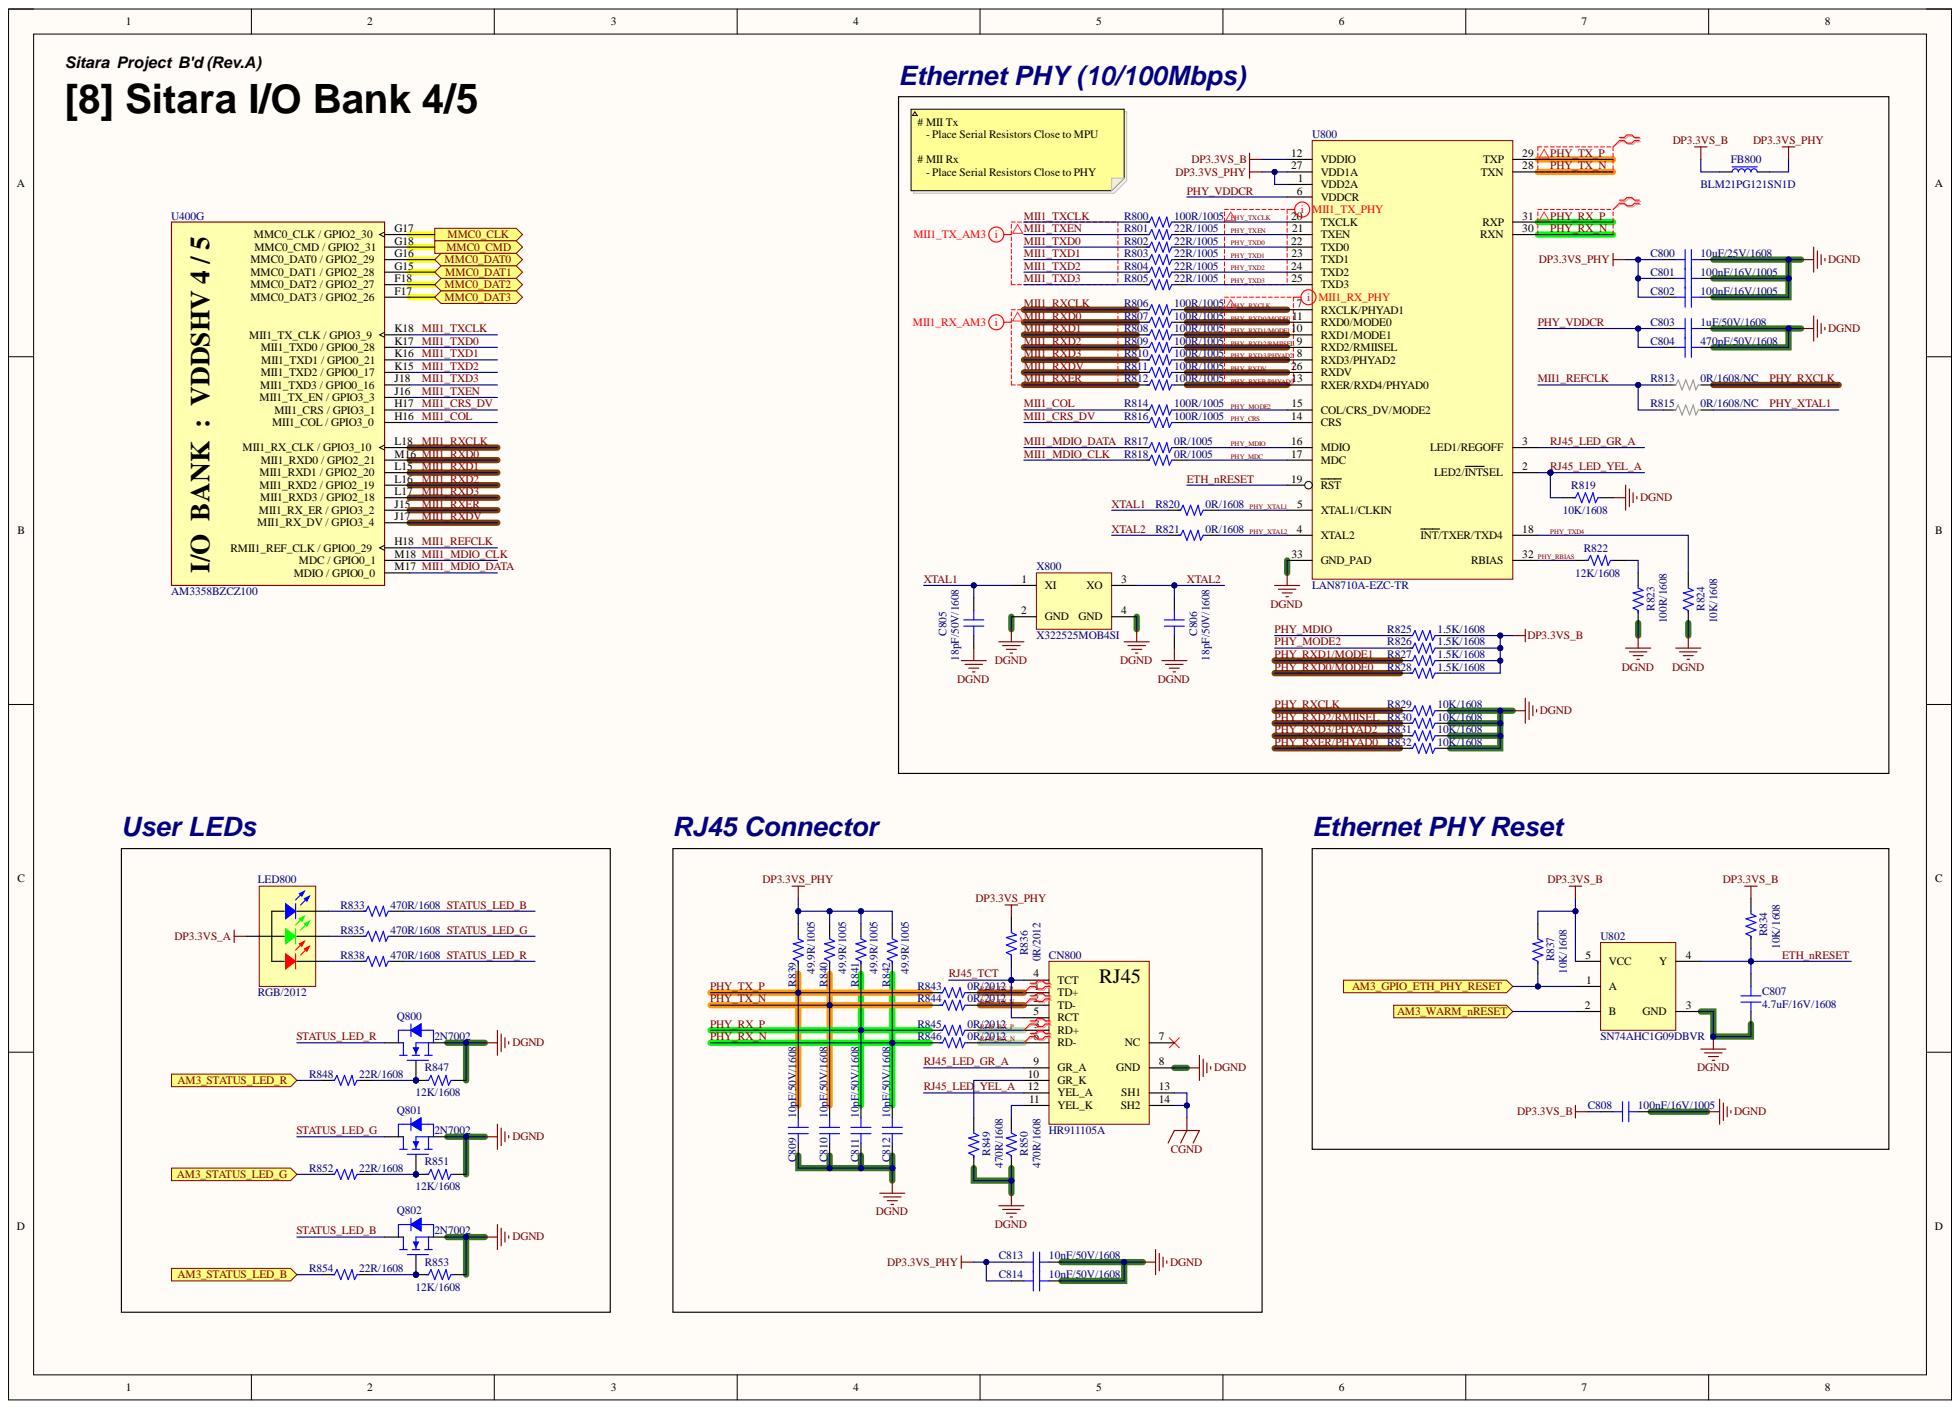
[picture p8: page 8]

# MII Tx
- Place Serial Resistors Close to MPU

# MII Rx
- Place Serial Resistors Close to PHY

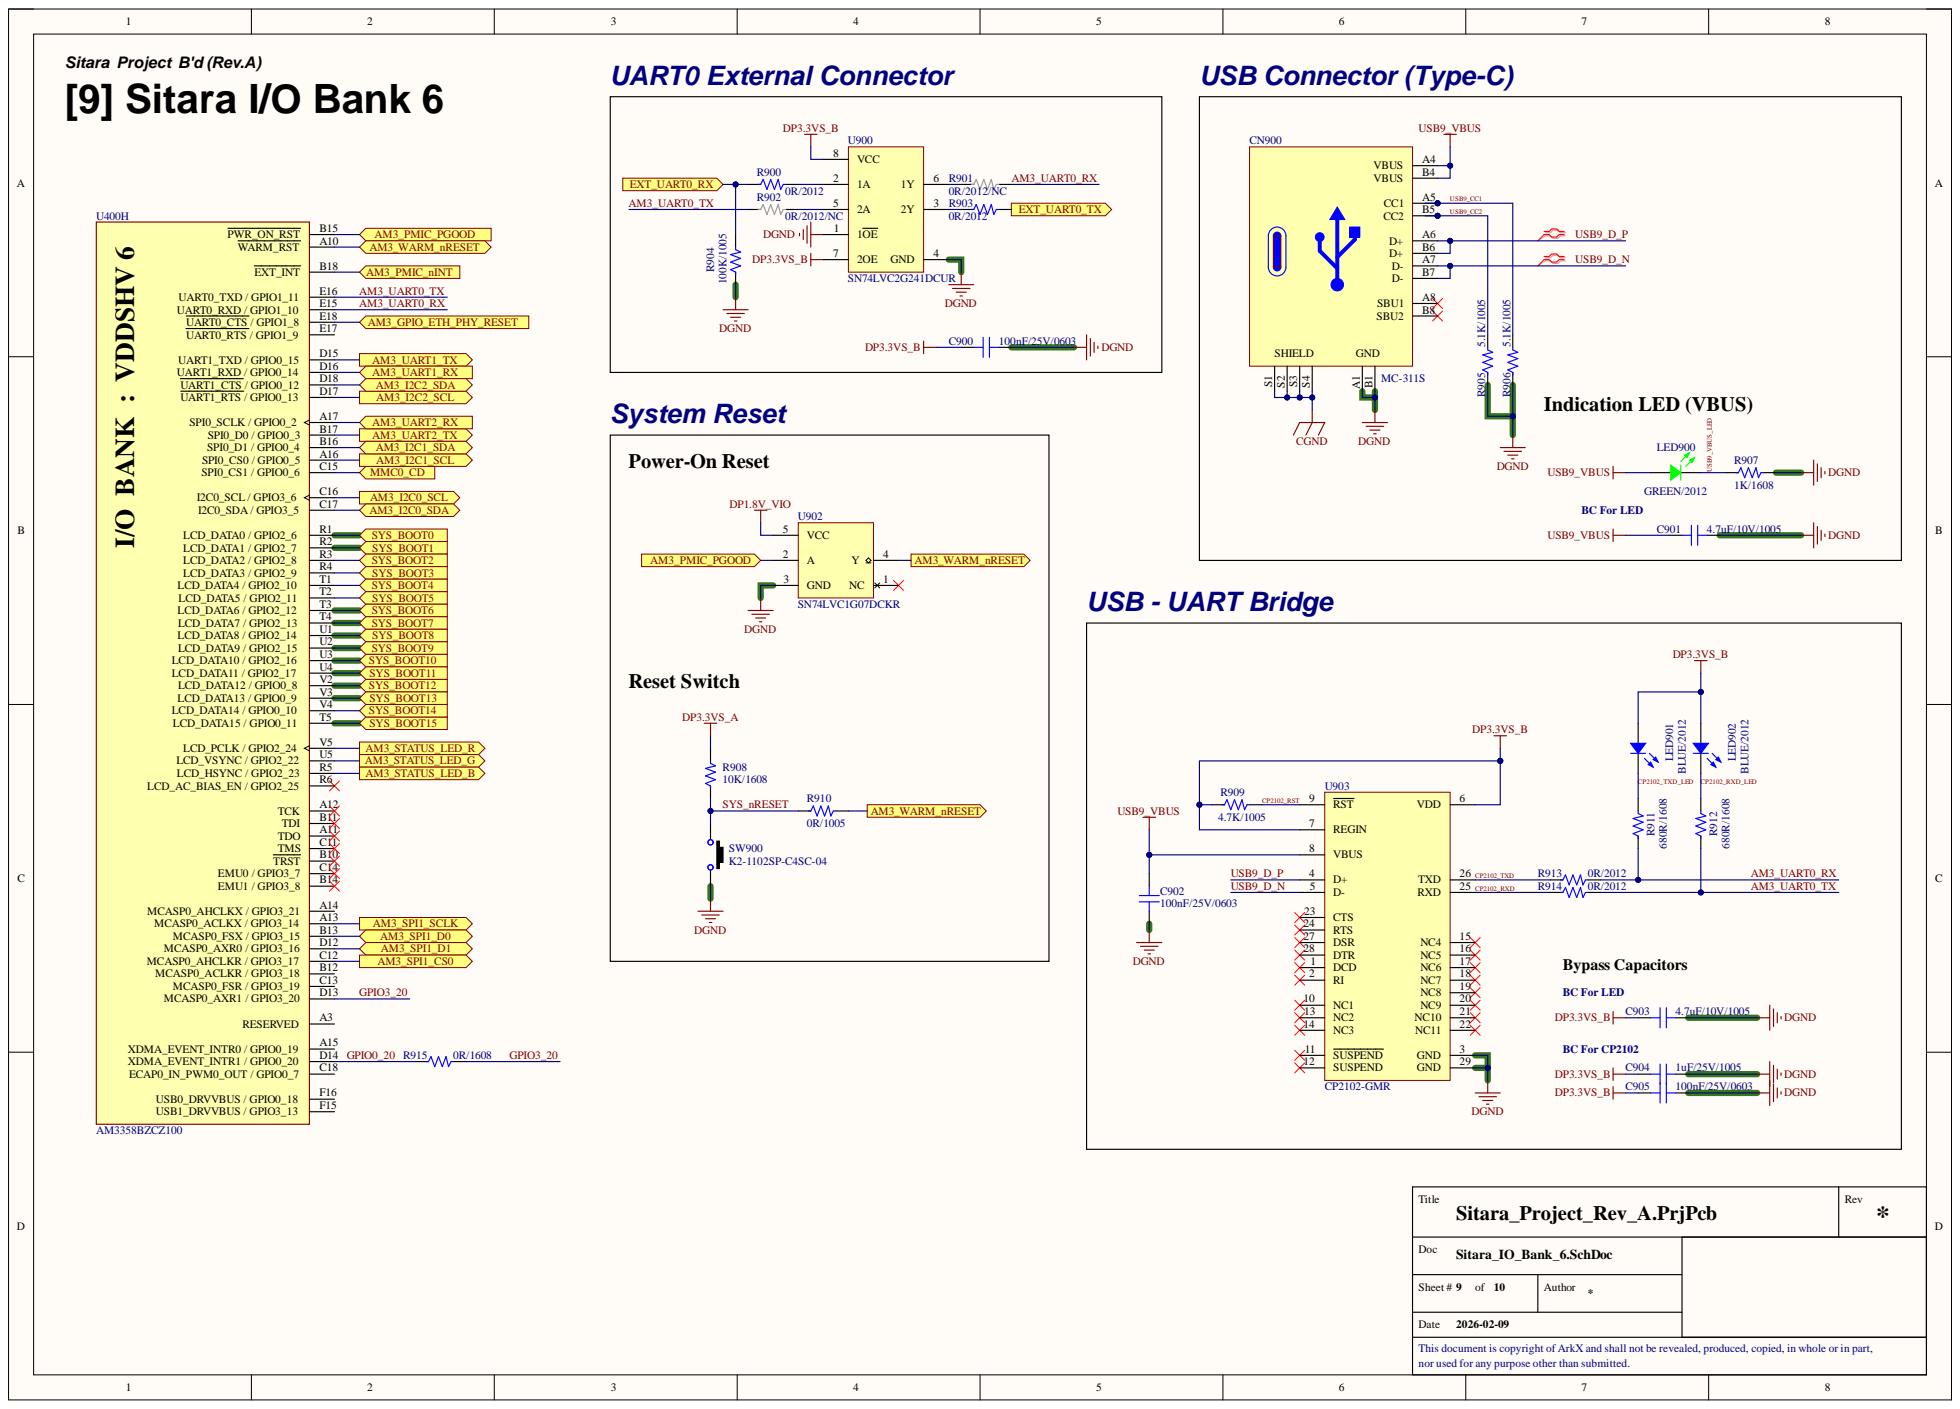
[picture p9: page 9]

Ti t l e Sitara_Project_Rev_A.Prj P c b | Rev *

Doc S itara_I O_Ban k_6.S c h D o c

Sheet # 9 of 10 | Autho r

s document
for any purpose other

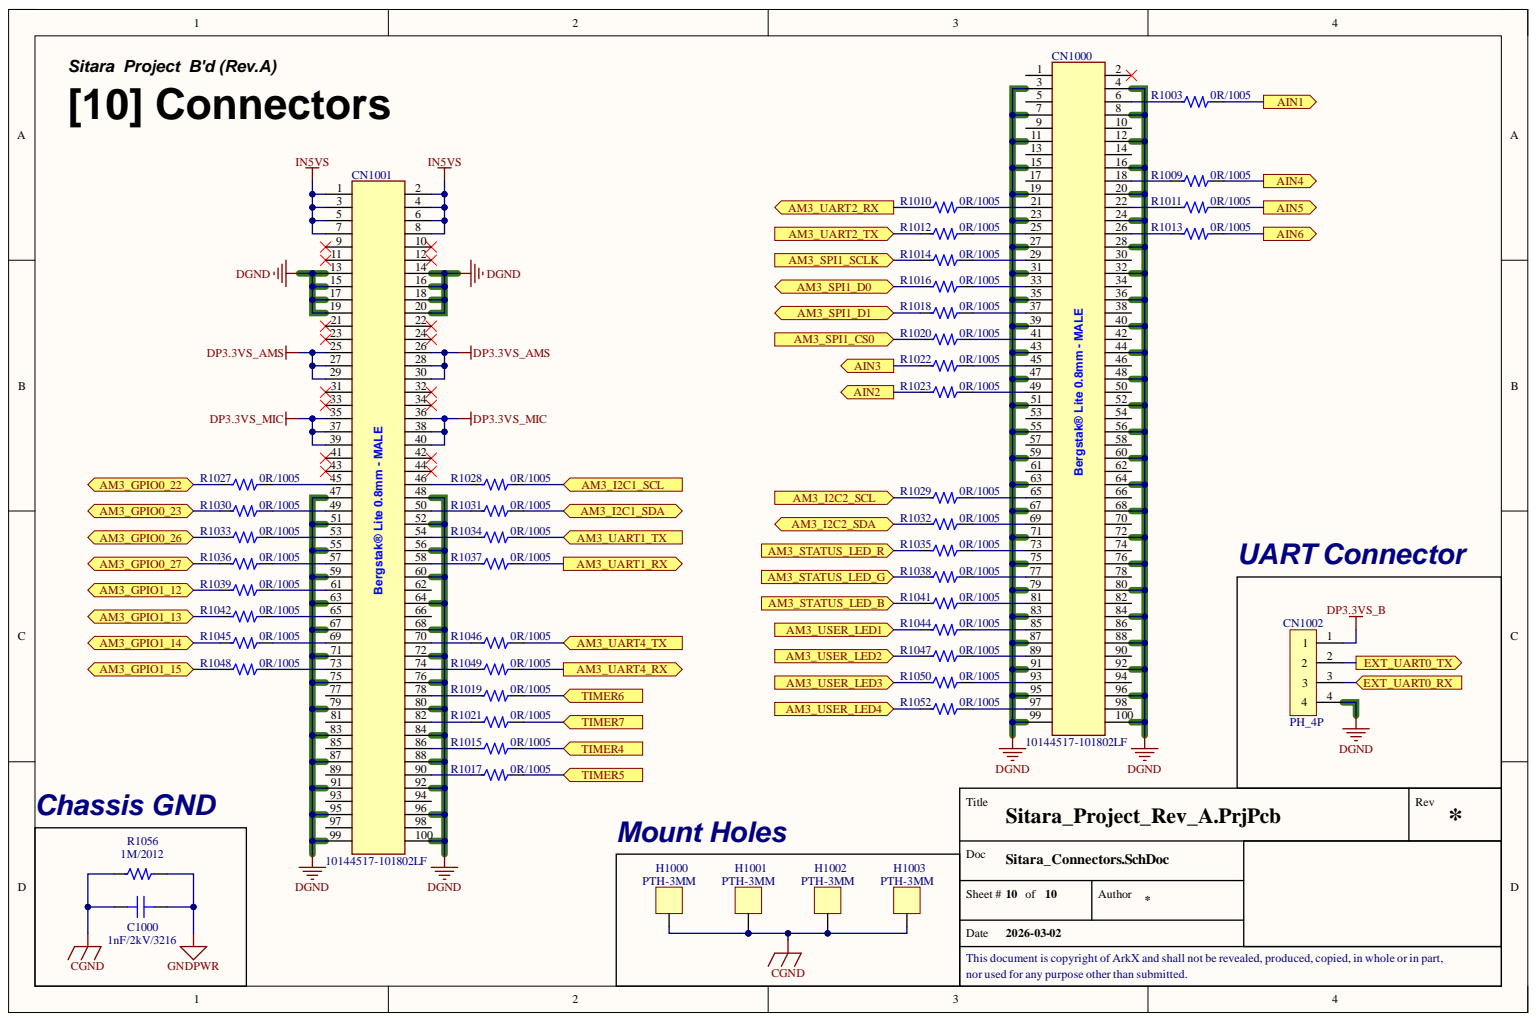
[picture p10: page 10]

Doc Sitara_Connectors.SchDoc

Sheet # 10 of 10 | Author *

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
