ArkX-Lab/Sitara-Project/(list of files, drawings)

Other design files:
HW/Rev_A/Sitara_Project_Rev_A/Sitara_Project_Rev_A/Index.SchDoc
HW/Rev_A/Sitara_Project_Rev_A/Sitara_Project_Rev_A/Overview.SchDoc
HW/Rev_A/Sitara_Project_Rev_A/Sitara_Project_Rev_A/Power.SchDoc
HW/Rev_A/Sitara_Project_Rev_A/Sitara_Project_Rev_A/Sitara_AUX.SchDoc
HW/Rev_A/Sitara_Project_Rev_A/Sitara_Project_Rev_A/Sitara_Connectors.SchDoc
HW/Rev_A/Sitara_Project_Rev_A/Sitara_Project_Rev_A/Sitara_DDR.SchDoc
HW/Rev_A/Sitara_Project_Rev_A/Sitara_Project_Rev_A/Sitara_IO_Bank_6.SchDoc
HW/Rev_A/Sitara_Project_Rev_A/Sitara_Project_Rev_A/Sitara_IO_Bank_45.SchDoc
HW/Rev_A/Sitara_Project_Rev_A/Sitara_Project_Rev_A/Sitara_IO_Bank_123.SchDoc
HW/Rev_A/Sitara_Project_Rev_A/Sitara_Project_Rev_A/Sitara_Power.SchDoc
HW/Rev_A/Sitara_Project_Rev_A/Sitara_Project_Rev_A/Sitara_Project_Rev_A.PrjPcb
HW/Rev_A/Sitara_Project_Rev_A/Sitara_Project_Rev_A/Sitara_Project_Rev_A_PCB.PcbDoc
