ArkX-Lab/Sitara-Project/(commit log)

2025-01-16 [HW] Add : Reference Schematic "BeagleBoneBlack Rev.C3"
2025-01-16 [HW] Add : Main Part List of BeagleBoneBlack
    [Main Part List of BeagleBoneBlack.xlsx]
2025-01-26 [HW] Add : Altium Project of Sitara Project B'd (Rev.A)
    - Set Project Options
    - Add Index, Overview Page
    [Index.SchDoc, Overview.SchDoc, Sitara_Project_Rev_A.PrjPcb]
2025-01-27 [HW] Add : PMIC Application Manual
    - Powering the AM335x with the TPS65217x
2025-01-27 [HW] Add : PMIC Pin-map
    - PMIC Part Name : TPS65217DRSLR
    [TPS65217DRSLR Pin-map.xlsx]
2025-01-28 [HW] Add : Details of PMIC Pin-map
    [TPS65217DRSLR Pin-map.xlsx]
2025-01-29 [HW] Add : Processor Pin-map
    - Processor Part Name : AM3358BZCZ100
    [AM3358BZCZ100 Pin-map.xlsx]
2025-01-30 [HW] Add : BeagleBoneBlack BOM
    Add BeagleBoneBlack BOM for Reference
    [BeagleBoneBlack_BOM.xls]
2025-01-31 [HW] Add : RJ45 Connector Datasheet
    - Part Name : HR911105A
2025-02-02 [Chore] Re-organize Folder Structure
    [AM3358BZCZ100 Pin-map.xlsx, TPS65217DRSLR Pin-map.xlsx]
2025-02-11 [HW] Add : Power Sheet of Sitara Project B'd (Rev.A)
    [Power.SchDoc, Sitara_Project_Rev_A.PrjPcb]
2025-02-14 [HW] Add : DDR PCB Routing Guide Document (TI)
2025-02-15 [HW] Add : GPIO Port & Pin number to Processor Pin-map
    [AM3358BZCZ100 Pin-map.xlsx]
2025-02-15 [HW] Add : Sitara Main Power & I/O Power Schematics
    - Sitara Main Power
    1. It is completed, but it needs to be reviewed
    - Sitara I/O Power
    1. It is work in progress
    [Power.SchDoc, Sitara_IO_Power.SchDoc, Sitara_Main_Power.SchDoc, Sitara_Project_Rev_A.PrjPcb]
2025-02-28 [HW] Add & Fix : DDR Schematic Page & Etc
    [B'd Design Check List.xlsx, DDR3L_Module.SchDoc, Main Part List of BeagleBoneBlack.xlsx, Power.SchDoc, Sch_Design_Check_List.SchDoc, Sitara_AUX.SchDoc, Sitara_DDR.SchDoc, Sitara_IO_Power.SchDoc]
2025-09-15 [HW] Commit before Fix DDR Part
    [Power.SchDoc, Sch_Design_Check_List.SchDoc, Sitara_AUX.SchDoc, Sitara_DDR.SchDoc, Sitara_IO_Bank_123.SchDoc, Sitara_IO_Bank_45.SchDoc, Sitara_IO_Bank_6.SchDoc, Sitara_Power.SchDoc]
2025-10-23 [HW] WIP
    [Power.SchDoc, Sitara_AUX.SchDoc, Sitara_DDR.SchDoc, Sitara_DDR_Old.SchDoc, Sitara_IO_Bank_123.SchDoc, Sitara_IO_Bank_45.SchDoc, Sitara_IO_Bank_6.SchDoc, Sitara_Power.SchDoc]
2025-10-27 [HW] Schematic 1st Draft Done
    [DDR3L_Module.SchDoc, Power.SchDoc, Sch_Design_Check_List.SchDoc, Sitara_AUX.SchDoc, Sitara_Connectors.SchDoc, Sitara_DDR.SchDoc, Sitara_DDR_Old.SchDoc, Sitara_IO_Bank_123.SchDoc]
2025-10-31 [HW] Add PCB Doc & Group Components
    [Power.SchDoc, Sitara_AUX.SchDoc, Sitara_Connectors.SchDoc, Sitara_DDR.SchDoc, Sitara_IO_Bank_123.SchDoc, Sitara_IO_Bank_45.SchDoc, Sitara_IO_Bank_6.SchDoc, Sitara_Power.SchDoc]
2025-11-09 [HW] DDR Routing - ACC #1
    [Sitara_AUX.SchDoc, Sitara_Connectors.SchDoc, Sitara_DDR.SchDoc, Sitara_IO_Bank_123.SchDoc, Sitara_IO_Bank_45.SchDoc, Sitara_IO_Bank_6.SchDoc, Sitara_Project_Rev_A.PcbDoc]
2025-12-19 [HW] Reset Altium Project Design
    [Index.SchDoc, Overview.SchDoc, Power.SchDoc, Sch_Design_Check_List.SchDoc, Sitara_AUX.SchDoc, Sitara_Connectors.SchDoc, Sitara_DDR.SchDoc, Sitara_IO_Bank_123.SchDoc]
2026-01-04 [HW] Add : DDR3L Routing to PCB
    DDR3L Routing & Delay Mathcing is done
    [Index.SchDoc, Overview.SchDoc, Power.SchDoc, Sitara_AUX.SchDoc, Sitara_Connectors.SchDoc, Sitara_DDR.SchDoc, Sitara_IO_Bank_123.SchDoc, Sitara_IO_Bank_45.SchDoc]
